mahtoyash/Robotic-Arm/assets/Video Project 5.gif

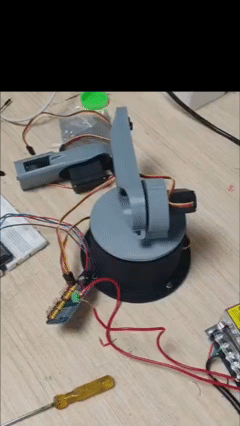
assets/Video Project 5.gif
