mahtoyash/Robotic-Arm/(commit log)

2026-11-06 feat: initial commit of 5-DOF voice-controlled robotic arm
    - Add ESP32 firmware for single-joint calibrations, manual web dashboard, and cloud/offline voice control
    - Add Python speech recognition server for Android Termux and PC
    - Add Web Voice Studio and automated build sync script
    - Add comprehensive README, hardware journal, architecture diagrams, and BOM
    - Add open-source files: LICENSE (MIT), CONTRIBUTING, CODE_OF_CONDUCT, and GitHub issue/PR templates
    - Configure .gitignore for build/cache hygiene and sanitize API credentials
2026-11-06 feat: enhance system architecture diagram with modern palette and add media gallery
    - Add high-contrast, colorful classDef styles to Mermaid architecture flowchart
    - Create assets/ directory for project media and diagrams
    - Add structured media showcase table with responsive cards in README
2026-11-06 docs(media): replace dashboard screenshot card with second motion demo GIF slot
2026-11-06 docs(media): add second demo GIF for arm motion routine
2026-11-06 docs(media): track assets/demo_motion.gif for arm articulation demo
